ZenithControlLabs/FrogBoard_HW/extras/testing_guide.md

---
geometry: margin=1in
---

## Continuity test

Check continuity between points connected in the two images:

### 3.3V net

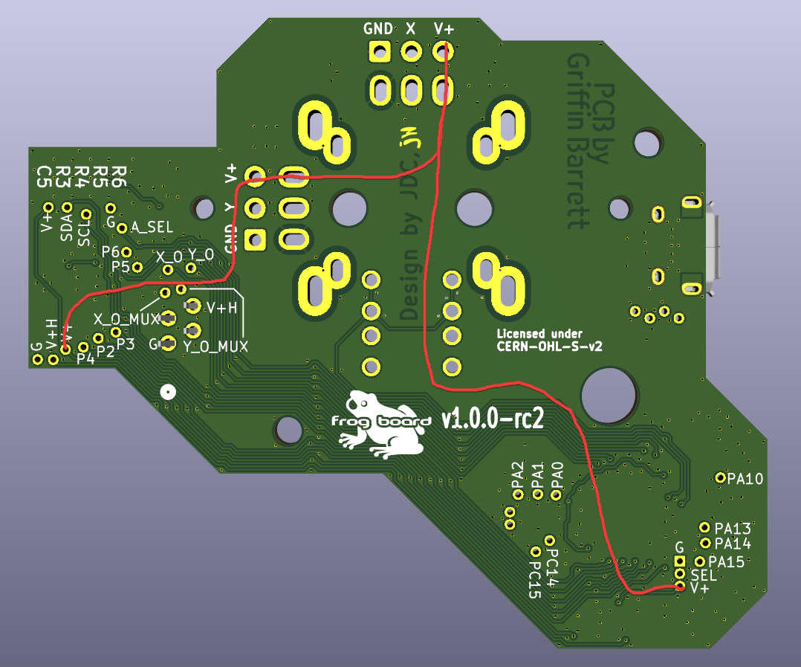
[picture p1: extras/3v3.png]


### GND net

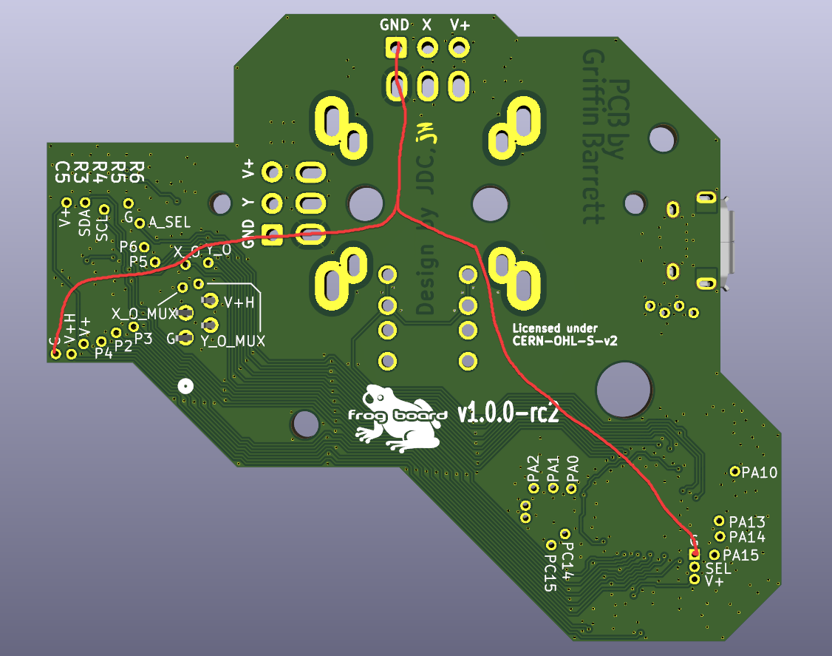
[picture p2: extras/gnd.png]


## Smoke test

Supply 3.3V power to the V+ pin and the GND (G) pin at the highlighted test points. 
Verify all boards behave "normally": no magic smoke, draws nonzero current, does not draw more than 0.3A.
Components may be warm but should not be hot to touch after running for any amount of time.

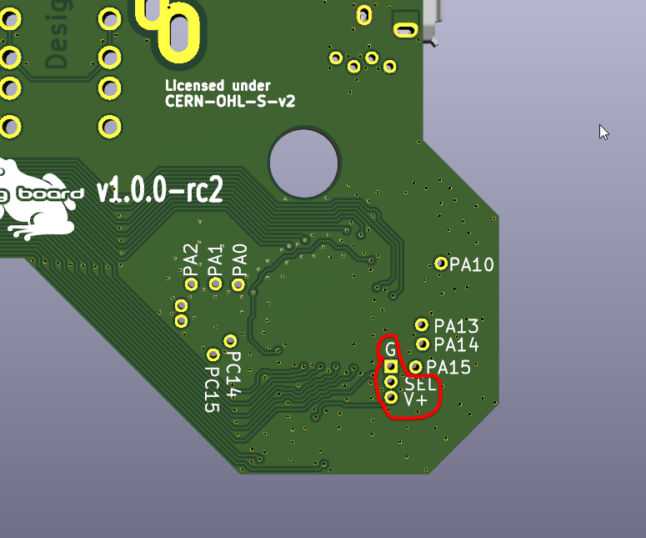
[picture p3: extras/testpoints.png]
