ZenithControlLabs/FrogBoard_HW/extras/v+h_vs_v+.png

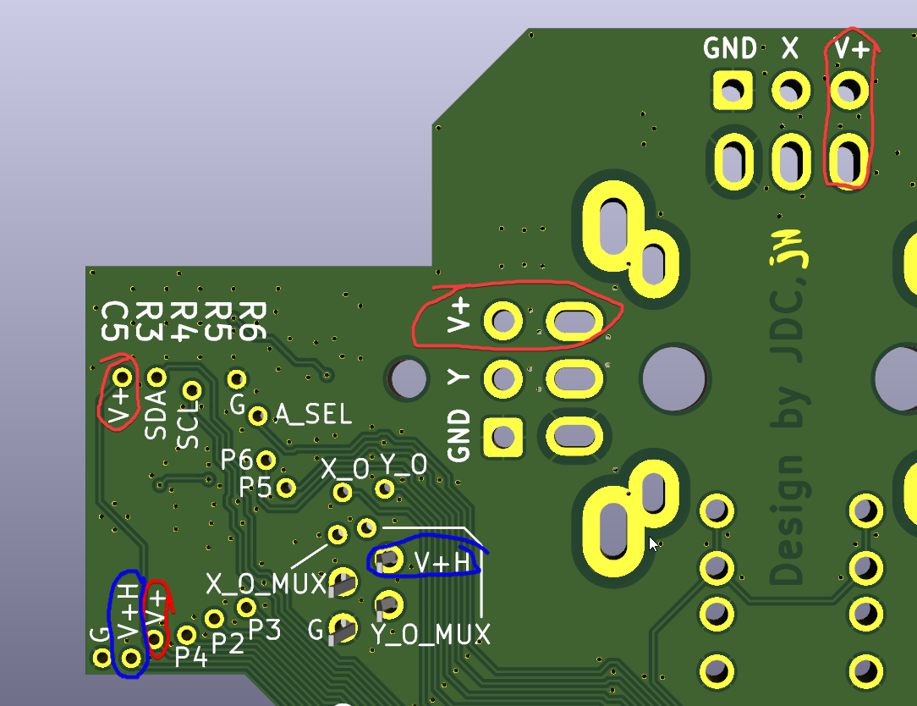
extras/v+h_vs_v+.png
