ZenithControlLabs/FrogBoard_HW/FrogBoard/FrogBoard.stl

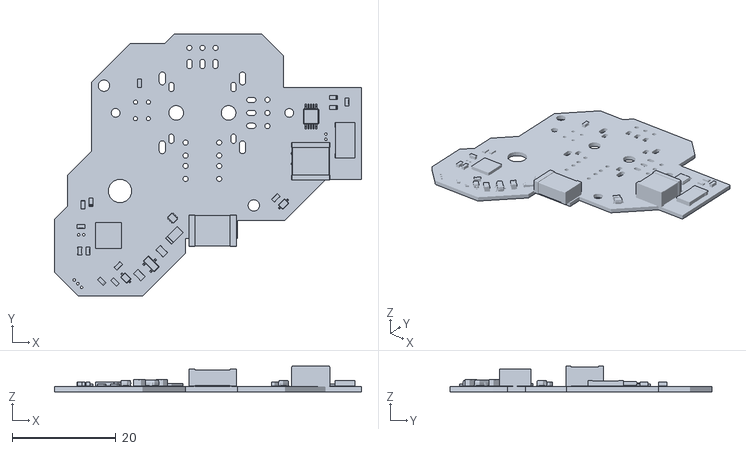
[picture p5: CAD file, 2025-10-12]
FrogBoard/FrogBoard.stl
59.3 x 50.6 x 4.95
