ZenithControlLabs/FrogBoard_HW/FrogBoard/FrogBoard_3Dmodels/10118194c.stp

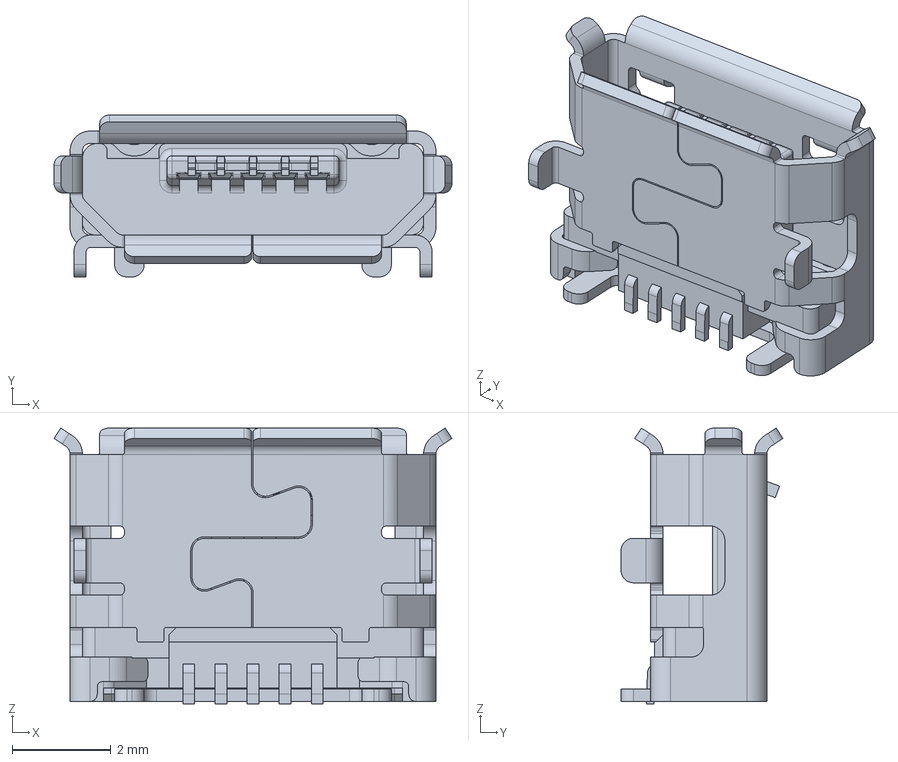
[picture p6: CAD file, 2025-09-14]
FrogBoard/FrogBoard_3Dmodels/10118194c.stp
8.05 x 3.27 x 5.58 mm
