ZenithControlLabs/FrogBoard_HW/FrogBoard/FrogBoard_3Dmodels/0528070410.stp

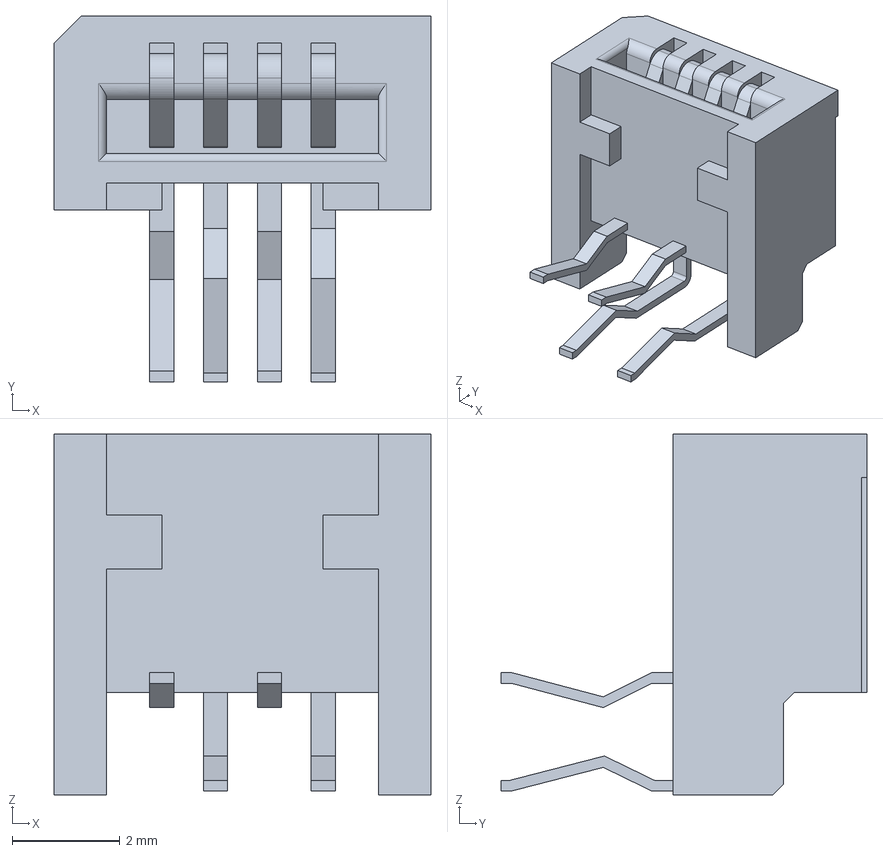
[picture p7: CAD file, 2025-09-14]
FrogBoard/FrogBoard_3Dmodels/0528070410.stp
7.00 x 6.80 x 6.70 mm
