ZenithControlLabs/FrogBoard_HW/FrogBoard/FrogBoard_3Dmodels/5034801000.stp

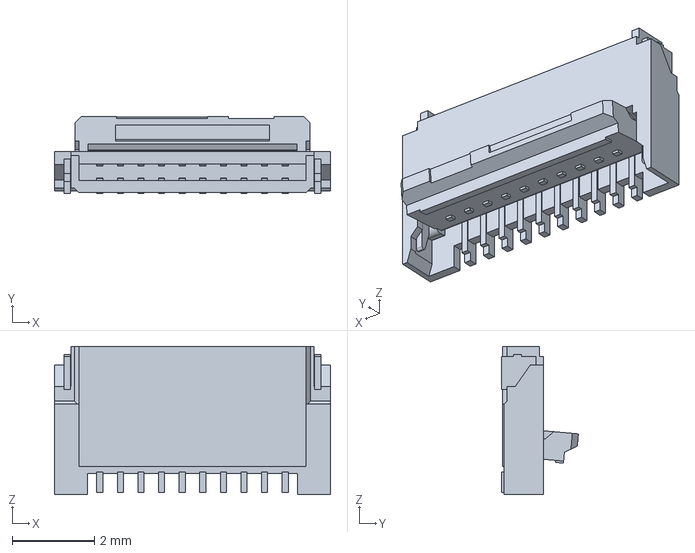
[picture p8: CAD file, 2025-09-14]
FrogBoard/FrogBoard_3Dmodels/5034801000.stp
6.70 x 1.87 x 3.60 mm
