ZenithControlLabs/FrogBoard_HW/FrogBoard/FrogBoard.kicad_pcb

## KiCad design FrogBoard/FrogBoard.kicad_pcb (2026-01-28)

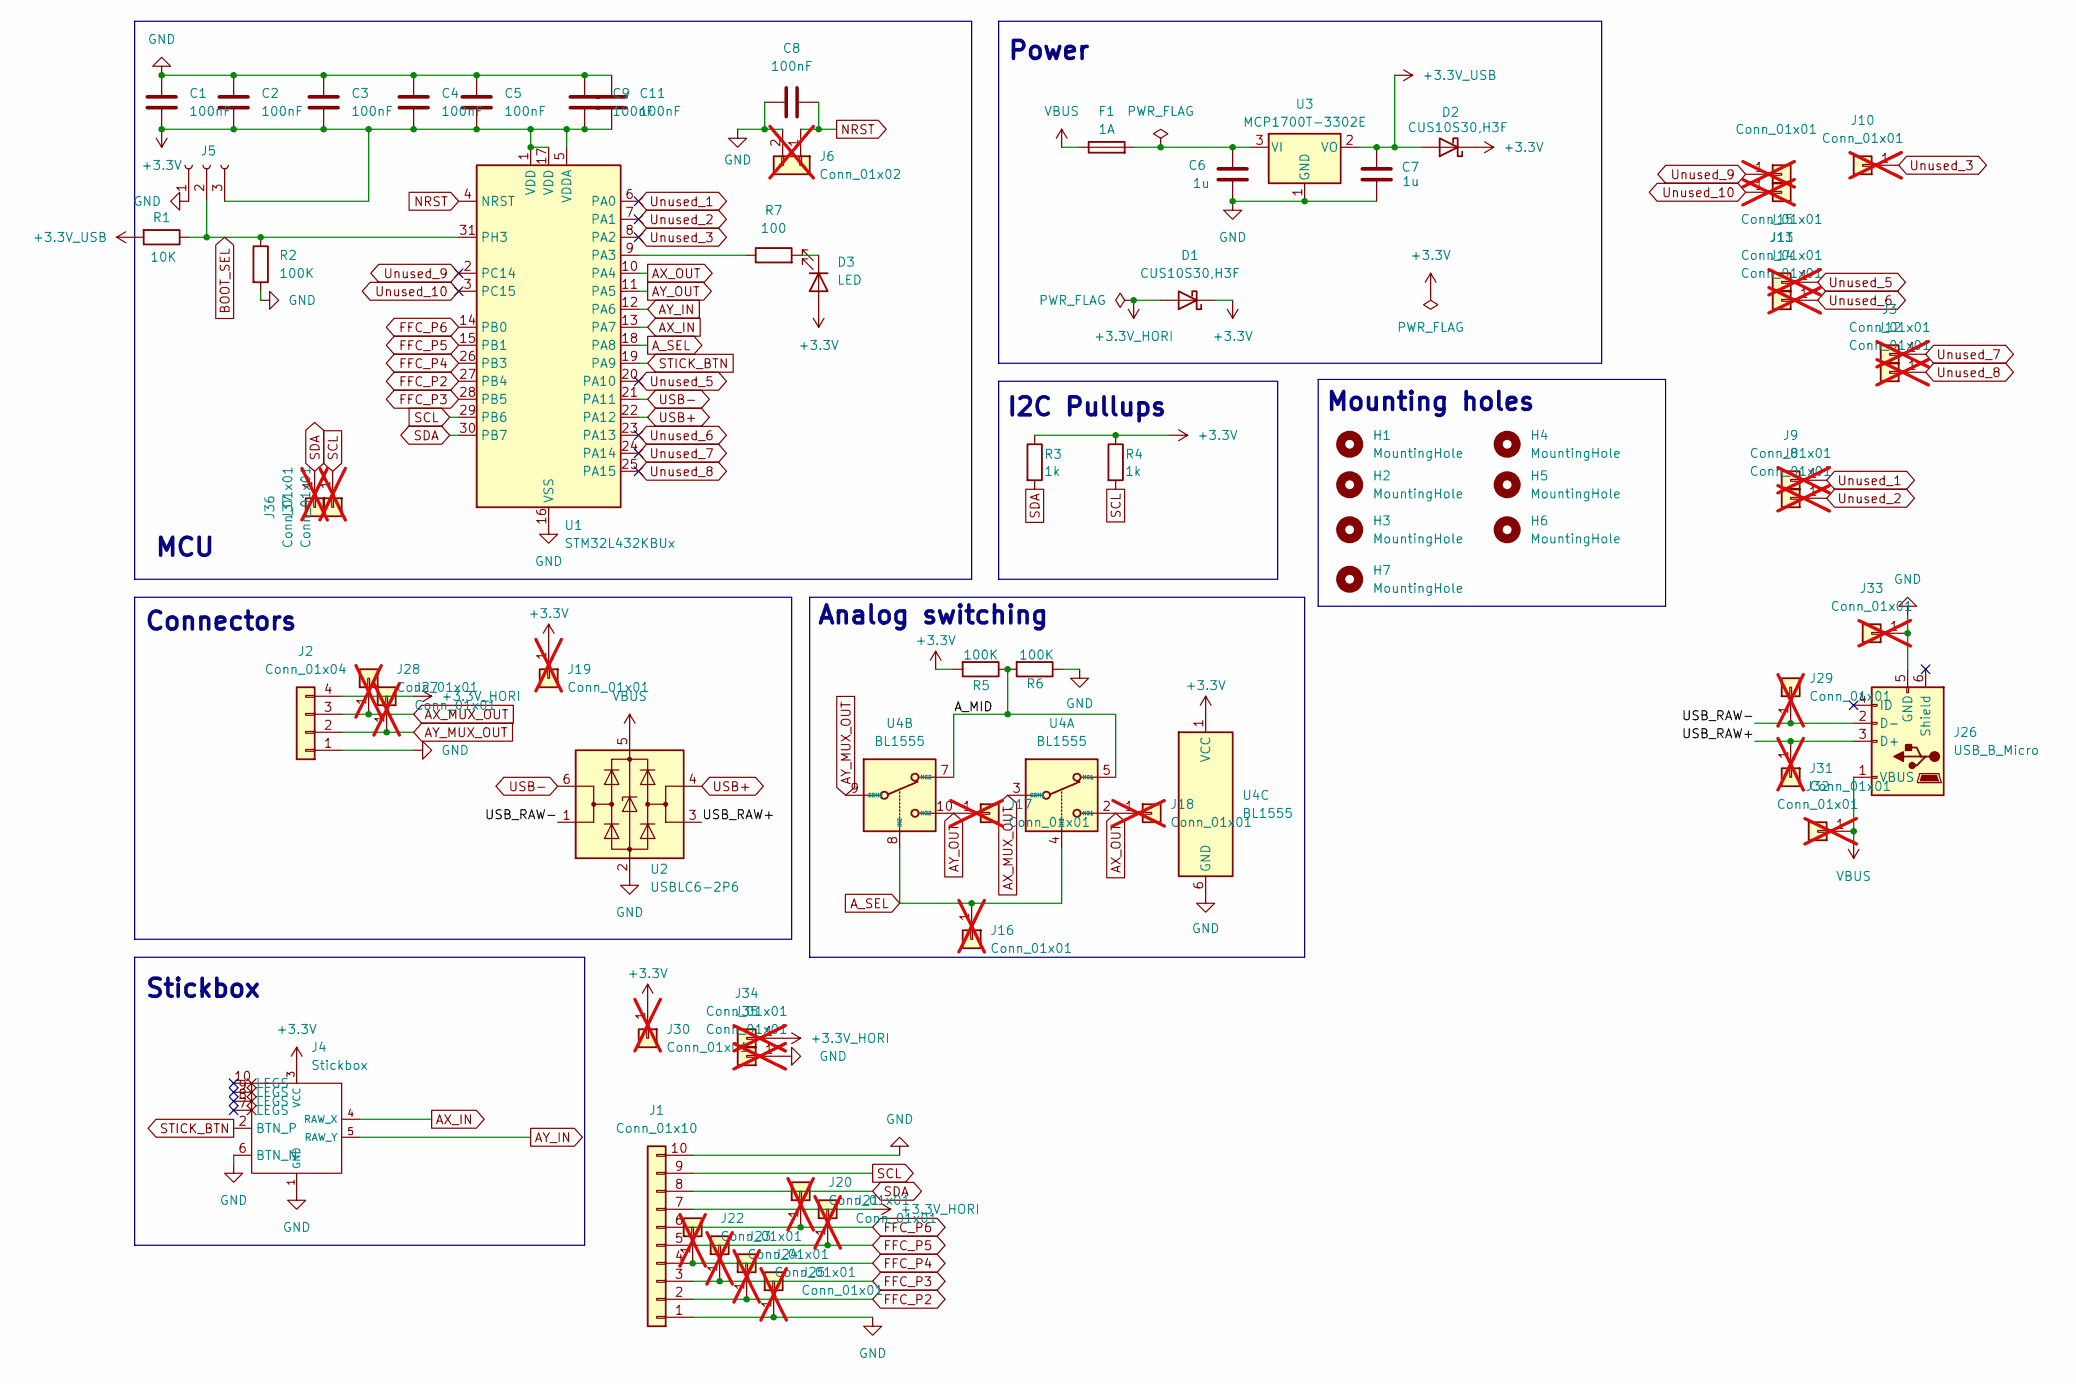
[picture p9: schematic FrogBoard.kicad_sch]

Parts:
C1, C2, C3, C4, C5, C8, C9, C11: 100nF; C_0603_1608Metric_Pad1.08x0.95mm_HandSolder; MPN CL10B104KB8NNNC; LCSC C1591
C6, C7: 1u; C_0805_2012Metric_Pad1.18x1.45mm_HandSolder; MPN CL21B105KBFNNNE; LCSC C28323
D1, D2: CUS10S30,H3F; D_SOD-323; MPN CUS10S30,H3F; LCSC C146335
D3: LED; LED_0603_1608Metric; MPN YLED0603R; LCSC C19171390
F1: 1A; Fuse_1206_3216Metric_Pad1.42x1.75mm_HandSolder; MPN nSMD050-33V; LCSC C70077
H1, H4: MountingHole; MountingHole_2.2mm_M2
H2, H5: MountingHole; MountingHole_1.7mm
H3, H6: MountingHole; MountingHole_2.833mm
H7: MountingHole; MountingHole_4.5mm
J1: Conn_01x10; CON_5034801000_MOL; MPN 5034801000; LCSC C127355
J2: Conn_01x04; CONN_528070410_MOL; MPN 528070410; LCSC C3170036
J3, J8, J9, J10, J11, J12, J13, J14, J15, J16, J17, J18, J19, J20, J21, J22, J23, J24, J25, J27, J28, J29, J30, J31, J32, J33, J34, J35, J36, J37: Conn_01x01; FrogBoard_PinHeader_1x01_P1.00mm_Vertical; not fitted
J4: Stickbox
J5: Conn_01x03_Socket; PinHeader_1x03_P1.00mm_Vertical
J6: Conn_01x02; PinHeader_1x02_P1.00mm_Vertical_Neutral_No_Coutryard; not fitted
J26: USB_B_Micro; AMPHENOL_10118194-0001LF; MPN 10118194-0001LF; LCSC C132563
R1: 10K; R_0603_1608Metric_Pad0.98x0.95mm_HandSolder; MPN RC0603FR-0710KL; LCSC C98220
R2, R5, R6: 100K; R_0603_1608Metric_Pad0.98x0.95mm_HandSolder; MPN RC0603FR-07100KL; LCSC C14675
R3, R4: 1k; R_0603_1608Metric_Pad0.98x0.95mm_HandSolder; MPN RC0603FR-071KL; LCSC C22548
R7: 100; R_0603_1608Metric; MPN RC0603FR-07100RL; LCSC C105588
U1: STM32L432KBUx; QFN-32-1EP_5x5mm_P0.5mm_EP3.45x3.45mm; MPN STM32L432KBU6TR; LCSC C2928224
U2: USBLC6-2P6; SOT-666; MPN USBLC6-2P6; LCSC C2827693
U3: MCP1700T-3302E; SOT-23; MPN MCP1700T-3302E/TT; LCSC C39051
U4: BL1555; MSOP-10_3x3mm_P0.5mm; MPN BL1555MM; LCSC C2826598

Connections:
+3.3V: C1.2, C2.2, C3.2, C4.2, C5.2, C9.2, C11.2, D1.1 (K), D2.1 (K), D3.2 (A), J4.3 (VCC), J5.3, J19.1, J30.1, R3.1, R4.1, R5.2, U1.1 (VDD), U1.5 (VDDA), U1.17 (VDD), U4.1 (VCC)
+3.3V_HORI: D1.2 (A), J1.7, J2.4, J34.1
+3.3V_USB: C7.2, D2.2 (A), R1.2, U3.2 (VO)
/A_MID: R5.1, R6.2, U4.5 (NC1), U4.7 (NC2)
/USB_RAW+: J26.3 (D+), J31.1, U2.3 (I/O2)
/USB_RAW-: J26.2 (D-), J29.1, U2.1 (I/O1)
AX_IN: J4.4 (RAW_X), U1.13 (PA7)
AX_MUX_OUT: J2.3, J28.1, U4.3 (COM1)
AX_OUT: J18.1, U1.10 (PA4), U4.2 (NO1)
AY_IN: J4.5 (RAW_Y), U1.12 (PA6)
AY_MUX_OUT: J2.2, J27.1, U4.9 (COM2)
AY_OUT: J17.1, U1.11 (PA5), U4.10 (NO2)
A_SEL: J16.1, U1.18 (PA8), U4.4 (IN1), U4.8 (IN2)
BOOT_SEL: J5.2, R1.1, R2.1, U1.31 (PH3)
FFC_P2: J1.2, J24.1, U1.27 (PB4)
FFC_P3: J1.3, J23.1, U1.28 (PB5)
FFC_P4: J1.4, J22.1, U1.26 (PB3)
FFC_P5: J1.5, J21.1, U1.15 (PB1)
FFC_P6: J1.6, J20.1, U1.14 (PB0)
GND: C1.1, C2.1, C3.1, C4.1, C5.1, C6.2, C7.1, C8.1, C9.1, C11.1, J1.1, J1.10, J2.1, J4.1 (GND), J4.6 (BTN_N), J5.1, J6.2, J25.1, J26.5 (GND), J33.1, J35.1, R2.2, R6.1, U1.16 (VSS), U1.32 (VSS), U1.33 (VSS), U2.2 (GND), U3.1 (GND), U4.6 (GND)
NRST: C8.2, J6.1, U1.4 (NRST)
unnamed: D3.1 (K), R7.2
unnamed: R7.1, U1.9 (PA3)
unnamed: C6.1, F1.2, U3.3 (VI)
SCL: J1.9, J37.1, R4.2, U1.29 (PB6)
SDA: J1.8, J36.1, R3.2, U1.30 (PB7)
STICK_BTN: J4.2 (BTN_P), U1.19 (PA9)
USB+: U1.22 (PA12), U2.4 (I/O2)
USB-: U1.21 (PA11), U2.6 (I/O1)
Unused_1: J9.1, U1.6 (PA0)
Unused_2: J8.1, U1.7 (PA1)
Unused_3: J10.1, U1.8 (PA2)
Unused_5: J13.1, U1.20 (PA10)
Unused_6: J14.1, U1.23 (PA13)
Unused_7: J3.1, U1.24 (PA14)
Unused_8: J12.1, U1.25 (PA15)
Unused_9: J15.1, U1.2 (PC14)
Unused_10: J11.1, U1.3 (PC15)
VBUS: F1.1, J26.1 (VBUS), J32.1, U2.5 (VBUS)

Notes on the sheet:
Mounting holes
Power
Connectors
Stickbox
MCU
I2C Pullups
Analog switching

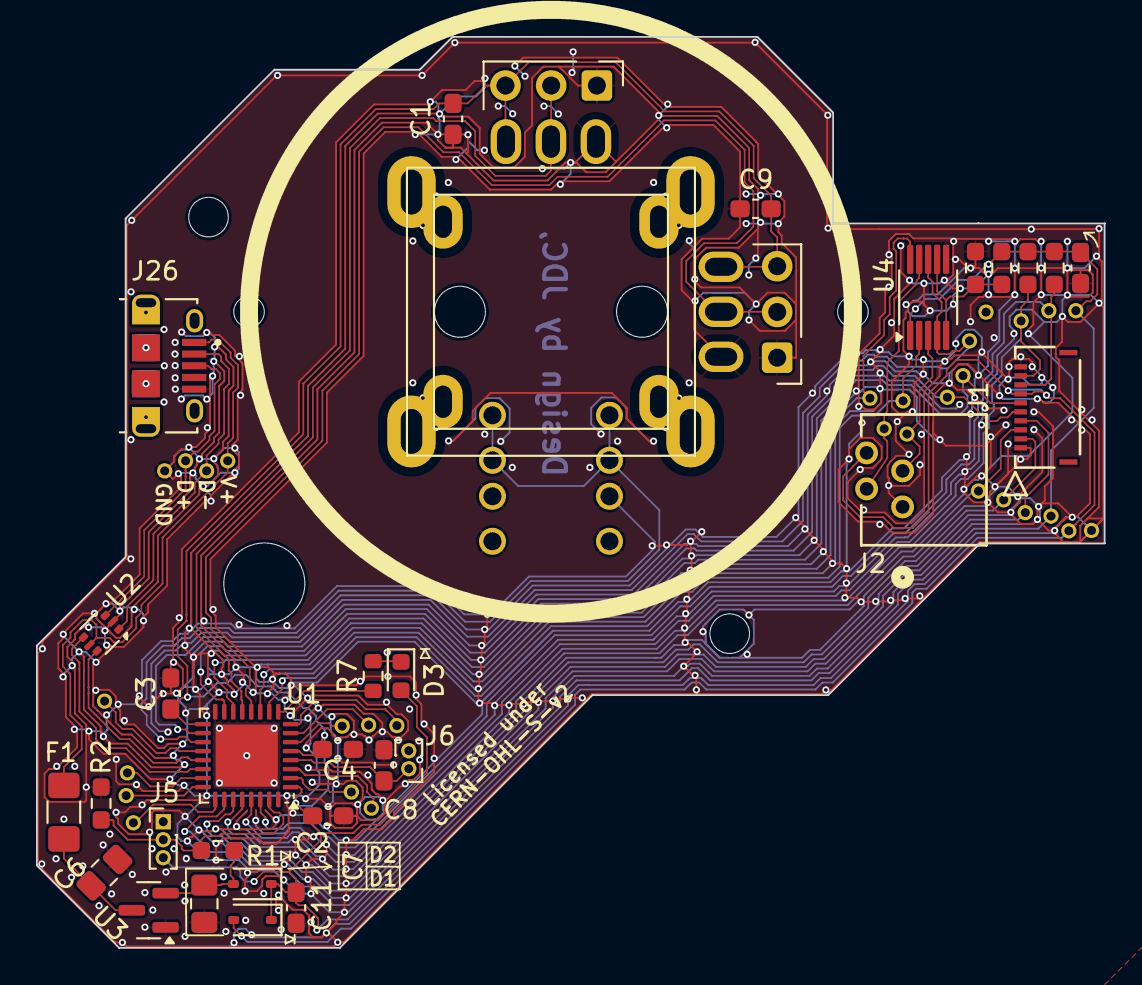
[picture p10: board FrogBoard.kicad_pcb from above]

Board: 2 copper layers, 59.3 x 50.6 mm, 68 parts (0 on the bottom side), 39 nets.
