ZenithControlLabs/FrogBoard_HW/(commit log)

2025-09-12 [skip ci] initial commit (empty design)
    [FrogBoard.kicad_pcb, FrogBoard.kicad_sch]
2025-09-12 1st draft of schematic
    [FrogBoard.kicad_pcb, FrogBoard.kicad_sch]
2025-09-14 PCB outline/initial layout
    [0528070410.stp, 10118194c.stp, 5034801000.stp, FrogBoard.kicad_pcb, FrogBoard.kicad_sch]
2025-09-15 Add mux for analog out lines, cleanup schematic
    [FrogBoard.kicad_pcb, FrogBoard.kicad_sch]
2025-09-15 round out pcb corners
    [FrogBoard.kicad_pcb]
2025-09-21 Cleaned up power filtering, fixed broken symbol and foorpting for mux, and started layout work
    [FrogBoard.kicad_pcb, FrogBoard.kicad_sch]
2025-09-21 routed the power section, places most ofthe components. Test points still to be added
    [FrogBoard.kicad_pcb, FrogBoard.kicad_sch]
2025-09-22 Switch to BL1555 analog chip
    [FrogBoard.kicad_pcb, FrogBoard.kicad_sch]
2025-10-07 first pass at layout
    [FrogBoard.kicad_pcb, FrogBoard.kicad_sch]
2025-10-07 Add NRST header, clean up silkscreens
    [FrogBoard.kicad_pcb, FrogBoard.kicad_sch]
2025-10-09 Integrated reset header
    [FrogBoard.kicad_pcb]
2025-10-10 Final board layout cleanup, added I2C testpoints
    [FrogBoard.kicad_pcb, FrogBoard.kicad_sch]
2025-10-10 Add part numbers, run DRC, add guide
    [FrogBoard.kicad_pcb, FrogBoard.kicad_sch]
2025-10-10 Fix ERC/DRC
    [FrogBoard.kicad_sch]
2025-10-10 ignore lib footprint mismatch for kibot ci
2025-10-12 Add notch in board outline for johnny's case; 3d model test
    [FrogBoard.kicad_pcb, FrogBoard.stl]
2025-10-13 more ground cleanups and stitching
    [FrogBoard.kicad_pcb]
2025-10-13 more refinement, also added DRC exclussions
    [FrogBoard.kicad_pcb]
2025-10-24 removed filter-cap positions and added testpoints for unused MCU pins
    [FrogBoard.kicad_pcb, FrogBoard.kicad_sch]
2025-10-26 Add LED
    [FrogBoard.kicad_pcb, FrogBoard.kicad_sch]
2025-10-29 adding indicator LED
    [FrogBoard.kicad_pcb, FrogBoard.kicad_sch]
2025-11-11 Replace micro B with USB-C connector
    [FrogBoard.kicad_pcb, FrogBoard.kicad_sch]
2025-11-18 Cleaned up board edge positions and layed out the main bus
    [FrogBoard.kicad_pcb, FrogBoard.kicad_sch]
2025-11-26 Update footprint and put back micro USB
    [FrogBoard.kicad_pcb, FrogBoard.kicad_sch]
2025-11-26 move usb into correct position
    [FrogBoard.kicad_pcb]
2025-12-05 bulk rounting done
    [FrogBoard.kicad_pcb, FrogBoard.kicad_sch]
2025-12-08 moved MCU south a bit for better routing
    [FrogBoard.kicad_pcb]
2025-12-28 electrically correct
    [FrogBoard.kicad_pcb, FrogBoard.kicad_sch]
2025-12-28 Should be copper complete
    [FrogBoard.kicad_pcb, FrogBoard.kicad_sch]
2026-01-18 Silkscreens and logo
    [FrogBoard.kicad_pcb]
2026-01-19 Grew and adjusted the feet of the stickbox
    [FrogBoard.kicad_pcb, FrogBoard.kicad_sch]
2026-01-22 drc/erc fixes; fix BOM entries
    [FrogBoard.kicad_pcb, FrogBoard.kicad_sch]
2026-01-22 drc warning fix
    [FrogBoard.kicad_pcb]
2026-01-24 Change current limiting resistor R7 value to 100 from 1K
    [FrogBoard.kicad_pcb, FrogBoard.kicad_sch]
2026-01-24 R7 drc fix
    [FrogBoard.kicad_pcb, FrogBoard.kicad_sch]
2026-01-24 final copper cleanup
    [FrogBoard.kicad_pcb]
2026-01-28 Add silkscreens for J5 and update testing guide
    [FrogBoard.kicad_pcb]
