ZenithControlLabs/FrogBoard_HW/(notices)

Notices in the files:
FrogBoard/FrogBoard.kicad_pcb:
Licensed under
CERN-OHL-S-v2
